rhinodavid/rhinodavid_kicad/README.MD

# @rhinodavid KiCad Parts Library

<!-- This an autogenerated file! DO NOT EDIT. Update README.hbs and run generate script. <-->

> High quality eCAD parts made by me. Shared with you.

KiCad assets for parts I'm
using in my designs. These are parts that I couldn't find eCAD resources for on
the internet, so I made them by hand.

Most of these parts are available on
Digikey. Look for a link to Digikey in the symbol metadata.

## Compatibility

KiCad 6.0 and above

## Adding a part

- Add symbol to library using eSchema
- Add footprint to `rhinodavid.pretty` directory
- Add STEP file to `rhinodavid.pretty` directory
  - Make sure the 3D model is assigned to and properly positioned on the footprint
- Add images to `./docs/readme/img`
- Update `./docs/readme/data.json` with the new part
- Regenerate the README
  - This requires the [Handlebars CLI](https://www.npmjs.com/package/hbs-cli)
  - Run `./docs/readme/generate.sh`

## Parts

### Legend

<div>
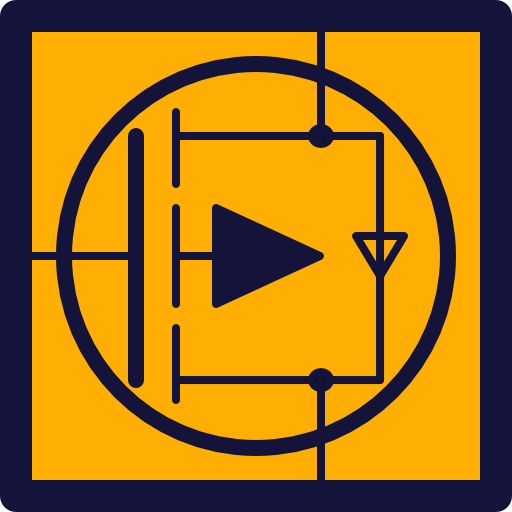
[picture p1: docs/readme/symbol_icon_alternate.png]
Symbol available
        
        <span>Symbol included</span>
</div>
<div>
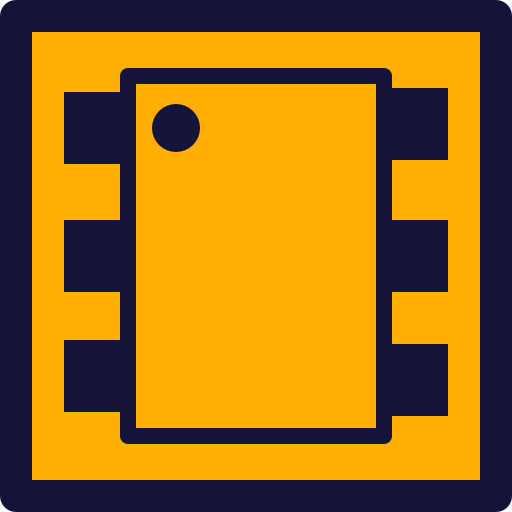
[picture p2: docs/readme/footprint_icon_alternate.png]
Footprint available
        
        <span>Footprint included</span>
</div>
<div>
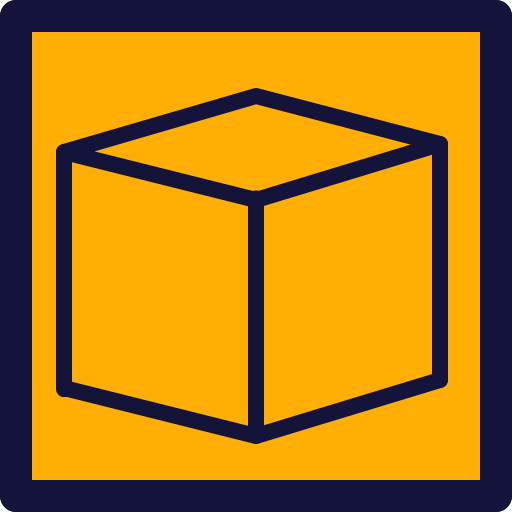
[picture p3: docs/readme/model_icon_alternate.png]
Model available
        
        <span>3D model included</span>
</div>

### OLED_SSD1306_folded

<div display="flex">
        Symbol available
        Footprint available
        Model available
</div>

<p>

192x64 OLED display available on eBay and [buydisplay.com](https://www.buydisplay.com/datasheet-128x64-oled-module-spi-0-96-inch-graphic-displays-white-on-black).<br />The display is mounted face down and then folded backwards.

</p>

<div display="flex">
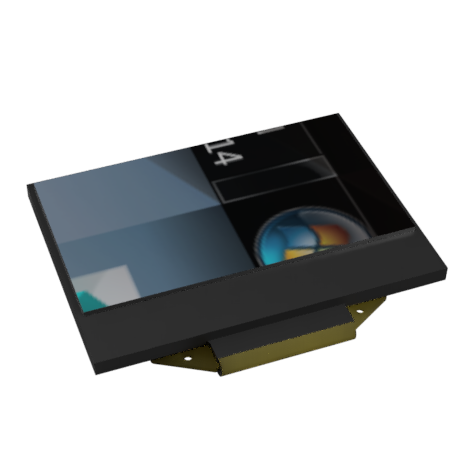
[picture p4: docs/readme/img/OLED-SSD1306-128X64_folded_render.png]
    
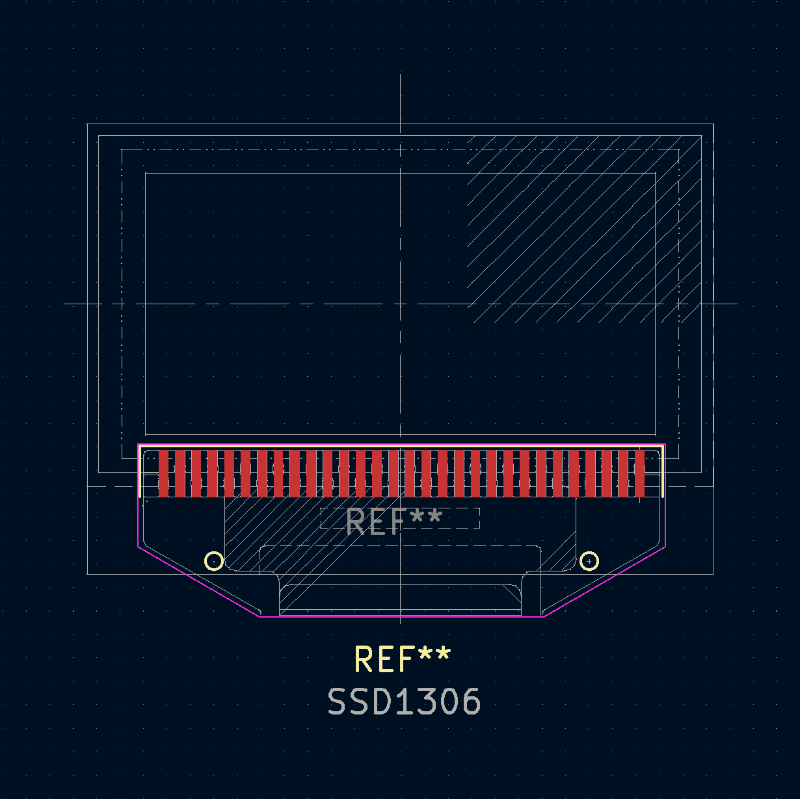
[picture p5: docs/readme/img/OLED-SSD1306-128X64_folded_footprint.png]
    
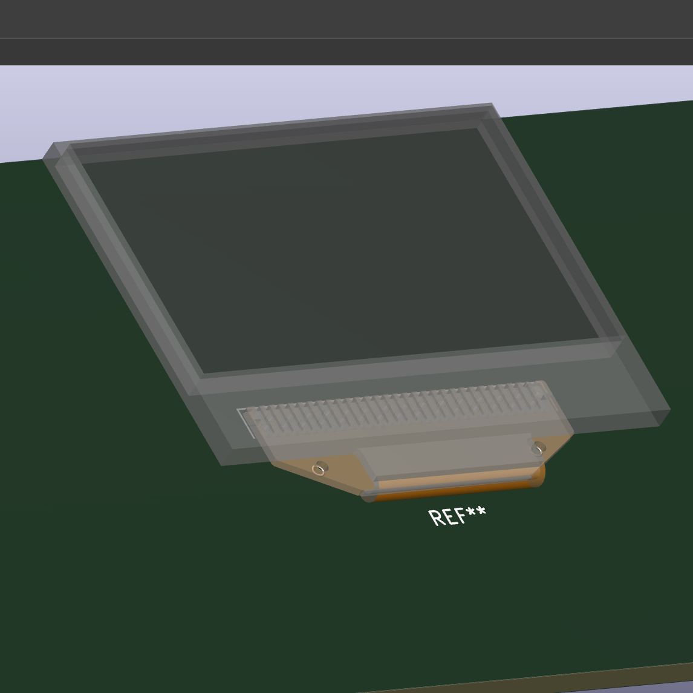
[picture p6: docs/readme/img/OLED-SSD1306-128X64_folded_model.png]
    
</div>

### MMSZ5261BT1G

<div display="flex">
        Symbol available
        Footprint available
        Model available
</div>

<p>

Zener Diode 47 V 500 mW ±5% Surface Mount SOD-123.

</p>

<div display="flex">
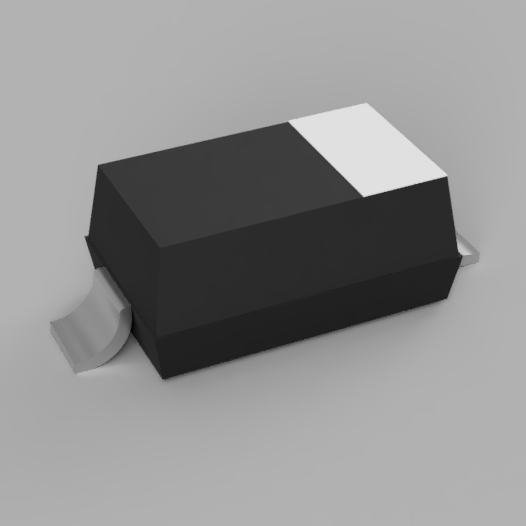
[picture p7: docs/readme/img/MMSZ5261BT1G_render.png]
    
</div>

### Adafruit Neopixel Mini 4957

<div display="flex">
        Symbol available
        Footprint available
        Model available
</div>

<p>

SK6812MINI Neopixel LED in a 3.5mm x 3.5mm package.

</p>

<div display="flex">
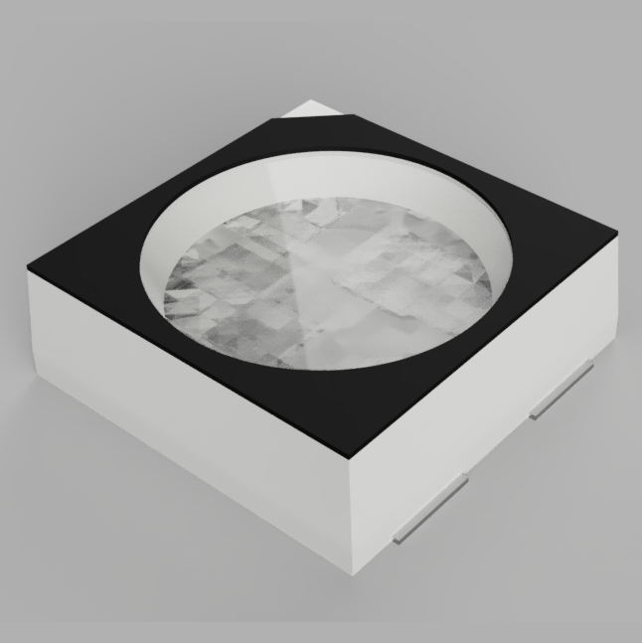
[picture p8: docs/readme/img/SK6812MINI_render.png]
    
</div>

### 1206L150TH

<div display="flex">
        Symbol available
        Footprint available
        Model available
</div>

<p>

Littelfuse, Inc. Polymeric PTC Resettable Fuse 8V 1.5 A in a SMD 1206 package.

</p>

<div display="flex">
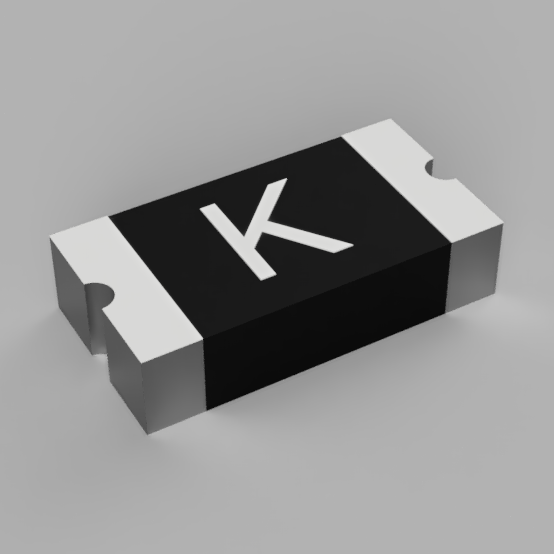
[picture p9: docs/readme/img/1206L150TH_render.png]
    
</div>

### SSM3J331R

<div display="flex">
        Symbol available
        Footprint available
        Model available
</div>

<p>

P-Channel SMD MOSFET, 20 V 4A 1W SOT-23F.

</p>

<div display="flex">
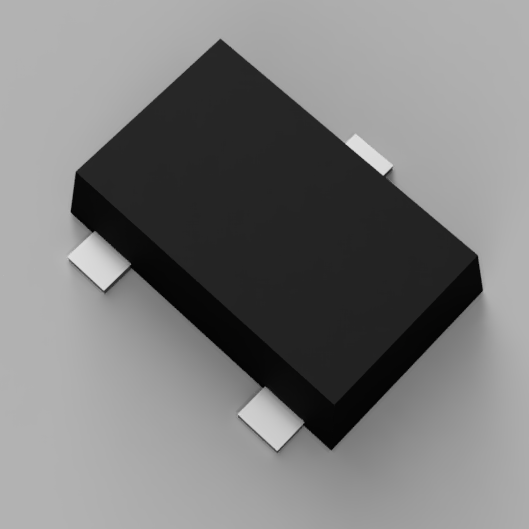
[picture p10: docs/readme/img/SSM3J331R_render.png]
    
</div>

### 74AUP1T00GX

<div display="flex">
        Symbol available
        Footprint available
        Model available
</div>

<p>

1 Channel Schmitt Trigger NAND Gate IC in a 5-X2SON (0.80mm x 0.80mm) package. Great for button debouncing.

</p>

<div display="flex">
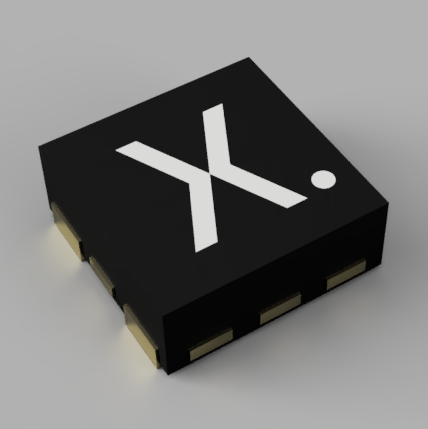
[picture p11: docs/readme/img/74AUP1T00GX_render_1.png]
    
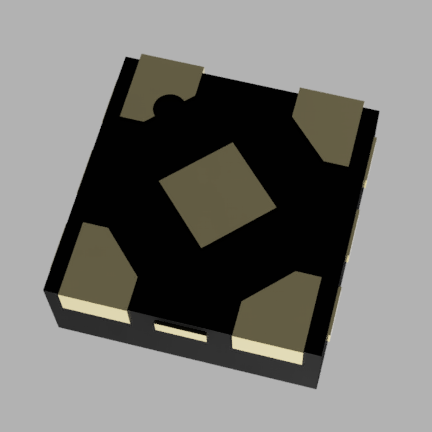
[picture p12: docs/readme/img/74AUP1T00GX_render_2.png]
    
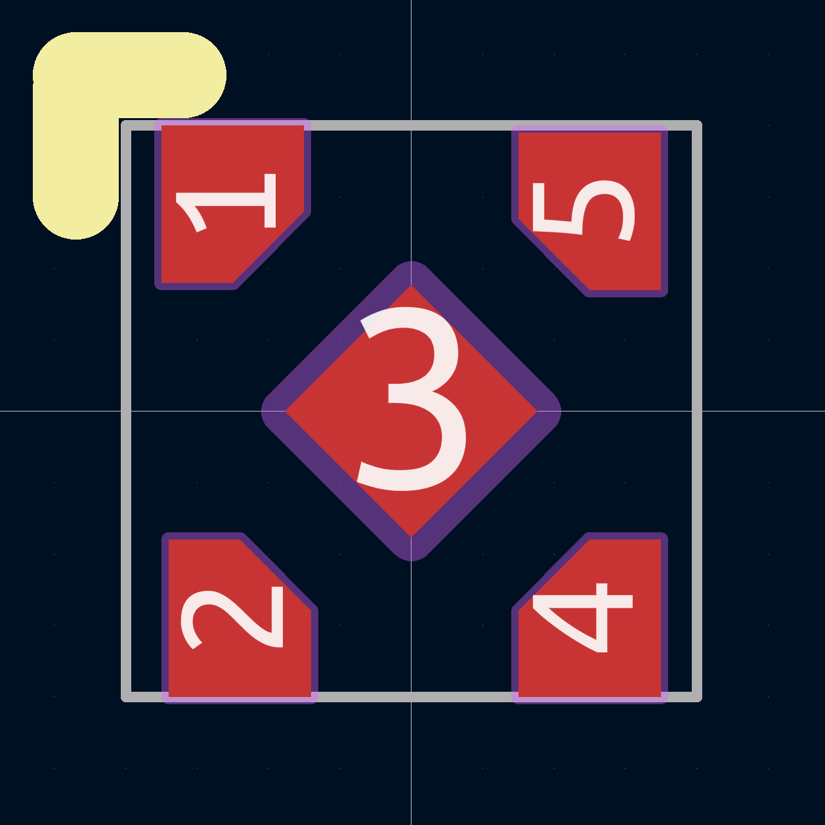
[picture p13: docs/readme/img/74AUP1T00GX_footprint.png]
    
</div>

### TLSM-D-T3-C-020-G

<div display="flex">
        Symbol available
        Footprint available
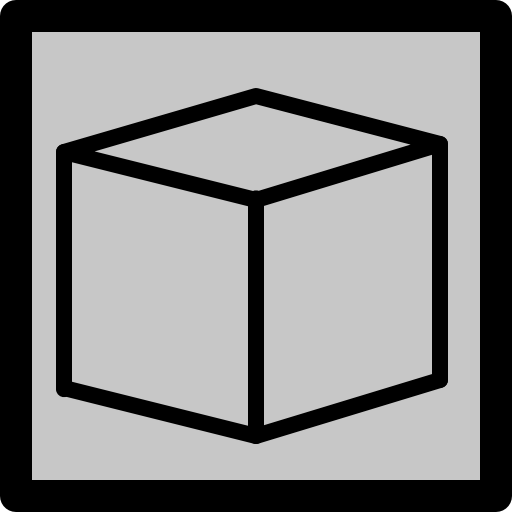
[picture p14: docs/readme/model_icon.png]
Model unavailable
        
</div>

<p>

6mm SPDT SMD tactile switch. Use with 74AUP1T00GX for a debounce.

</p>

<div display="flex">
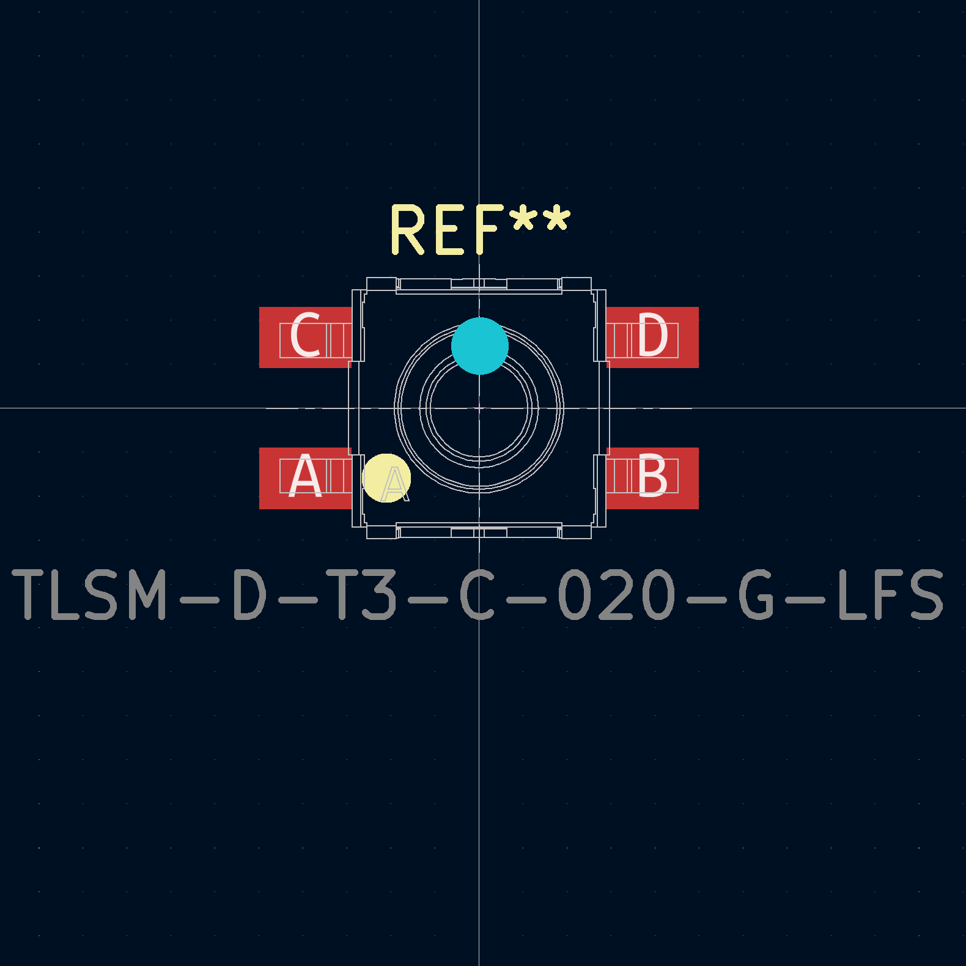
[picture p15: docs/readme/img/TLSM-D-T3-C-020-G-LFS.png]
    
</div>

### TBL003-254-04GR-2OR

<div display="flex">
        Symbol available
        Footprint available
        Model available
</div>

<p>

4 Position Wire to Board Terminal Block Horizontal 0.1" (2.54mm) Through Hole.

</p>

<div display="flex">
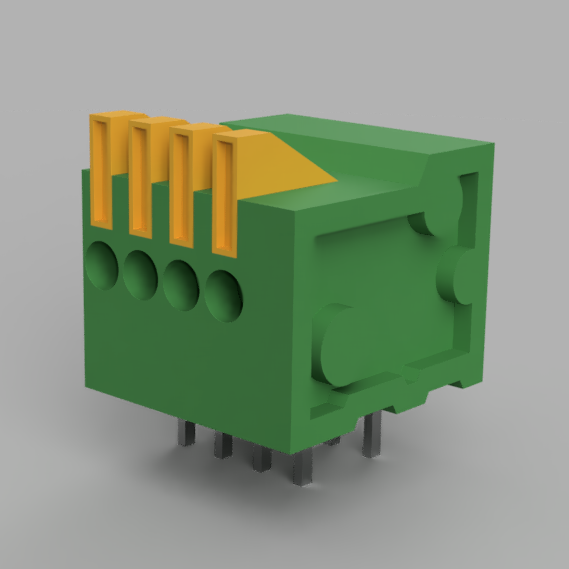
[picture p16: docs/readme/img/TBL003-254-04GR-2OR_render.png]
    
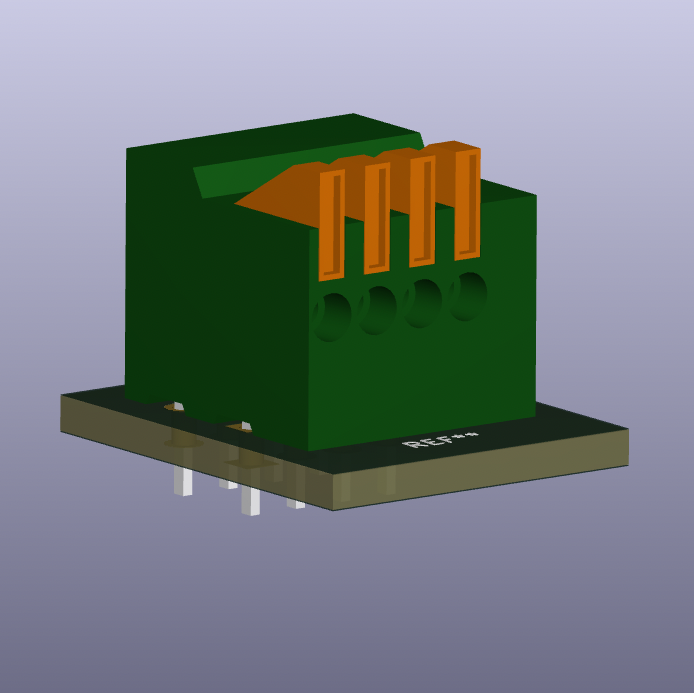
[picture p17: docs/readme/img/TBL003-254-04GR-2OR_model.png]
    
</div>

### BU33UV7NUX

<div display="flex">
        Symbol available
        Footprint available
        Model available
</div>

<p>

Synchronous Boost DC/DC Converter 3.3 V

</p>

### TPS61098x

<div display="flex">
        Symbol available
        Footprint available
        Model available
</div>

<p>

Ultra-Low Quiescent Current Synchronous Boost with Integrated LDO/Load Switch

</p>

<div display="flex">
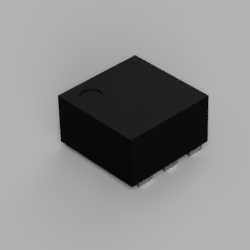
[picture p18: docs/readme/img/TPS61098x_render.png]
    
</div>

### 831068248

<div display="flex">
        Symbol available
        Footprint available
        Model available
</div>

<p>

Wurth Electronic IQXO-540 Standard 2 x 1.6 crystal oscillator in a ceramic package with a seam sealed metal lid, hermetically sealed.

</p>

<div display="flex">
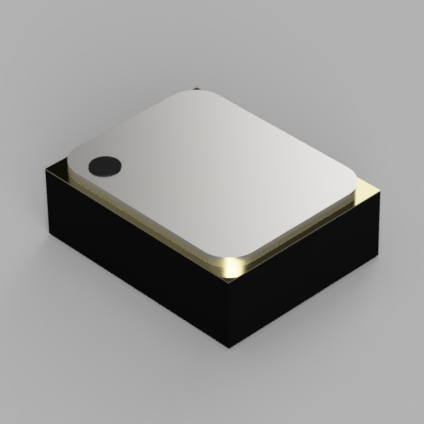
[picture p19: docs/readme/img/831068248_render.png]
    
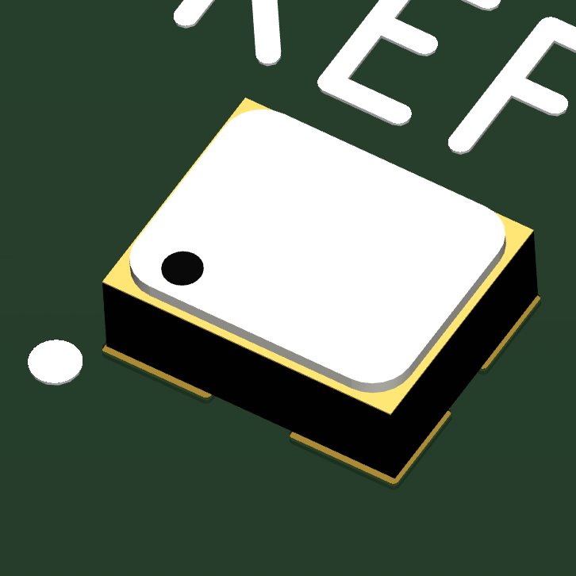
[picture p20: docs/readme/img/831068248_model.png]
    
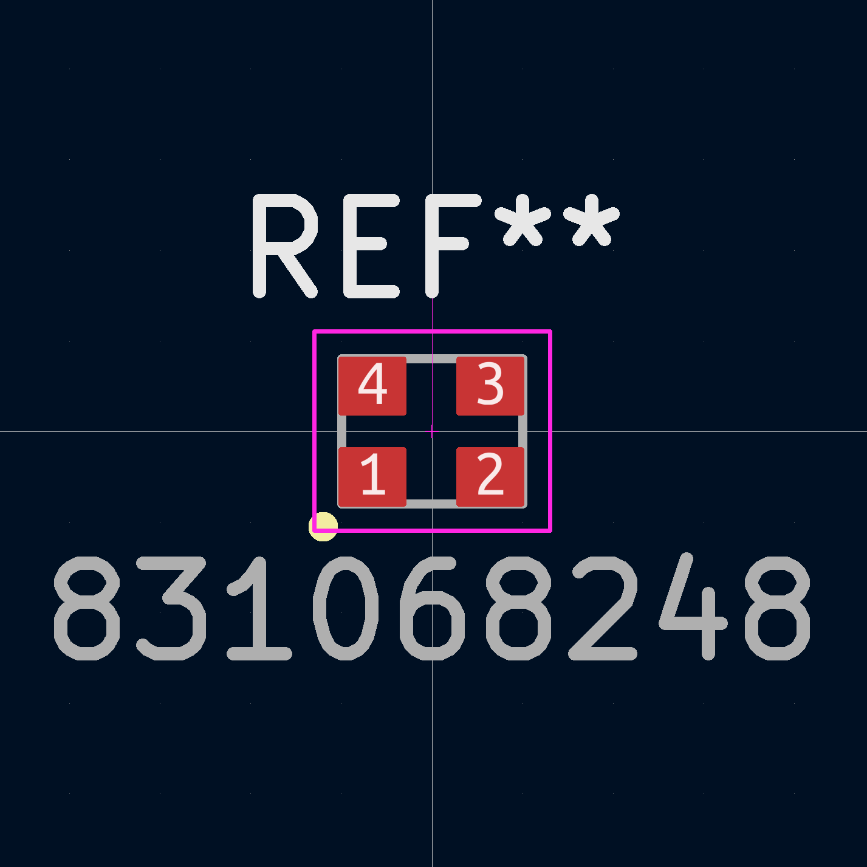
[picture p21: docs/readme/img/831068248_footprint.png]
    
</div>

### AMCA31-2R450G-S1F-T3

<div display="flex">
        Symbol available
        Footprint available
        Model available
</div>

<p>

Surface Mount WLAN / Bluetooth Chip Antenna (2450MHz)

</p>

<div display="flex">
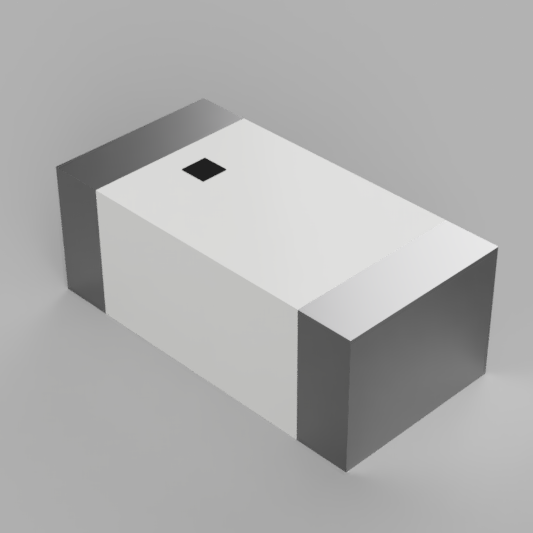
[picture p22: docs/readme/img/AMCA31-2R450G-S1F-T3_render.png]
    
</div>

### SMBJ8.0D-M3/H

<div display="flex">
        Symbol available
        Footprint available
        Model available
</div>

<p>

Vishay General Semiconductor TVS Diode 13.4VC; DO214AA package

</p>

<div display="flex">
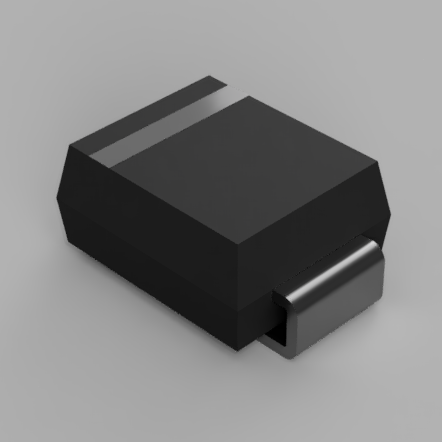
[picture p23: docs/readme/img/SMBJ8.0D-M3H_render.png]
    
</div>

### JTX310

<div display="flex">
        Symbol available
        Footprint available
        Model available
</div>

<p>

Jauch Quartz 32.768 kHz ±20ppm Crystal 7pF 70 kOhms 2-SMD, No Lead

</p>

<div display="flex">
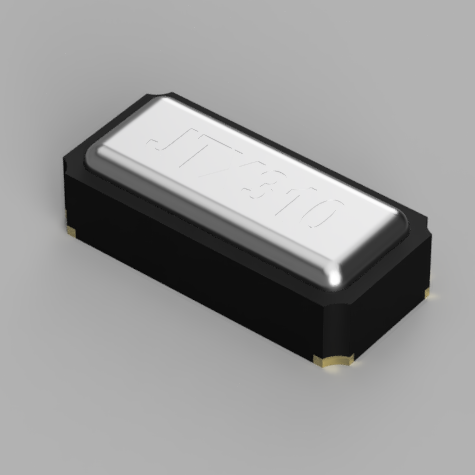
[picture p24: docs/readme/img/JTX310_render.png]
    
</div>

### DMN2005K-7

<div display="flex">
        Symbol available
        Footprint available
        Model available
</div>

<p>

Diodes Inc. N-Channel 20V 300mA (Ta) 350mW (Ta) Surface Mount SOT-23-3 MOSFET

</p>

<div display="flex">
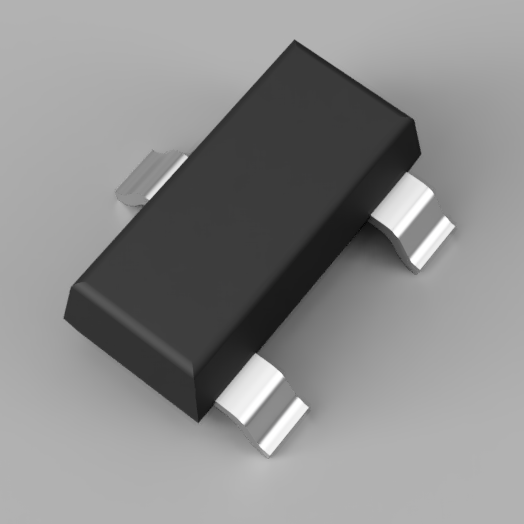
[picture p25: docs/readme/img/DMN2005K-7_render.png]
    
</div>

### LDL1117S33R

<div display="flex">
        Symbol available
        Footprint available
        Model available
</div>

<p>

STMicroelectronics Linear Voltage Regulator IC Positive Fixed 1 Output 1.2A SOT-223

</p>

<div display="flex">
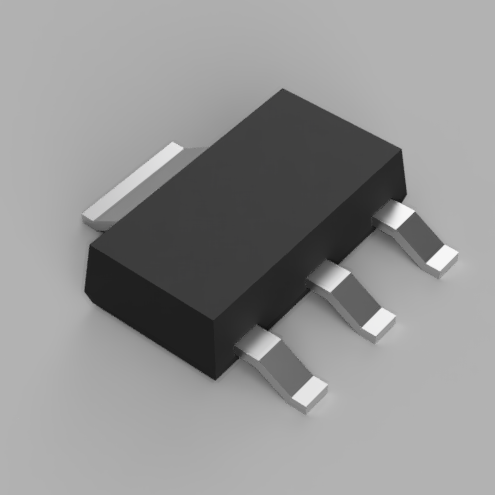
[picture p26: docs/readme/img/LDL1117S33R_render.png]
    
</div>

### PKMCS0909E4000-R1

<div display="flex">
        Symbol available
        Footprint available
        Model available
</div>

<p>

Murata Electronics Buzzer Transducer, Externally Driven Piezo 1.5 V - 4kHz 65dB @ 1.5V, 10cm Surface Mount

</p>

<div display="flex">
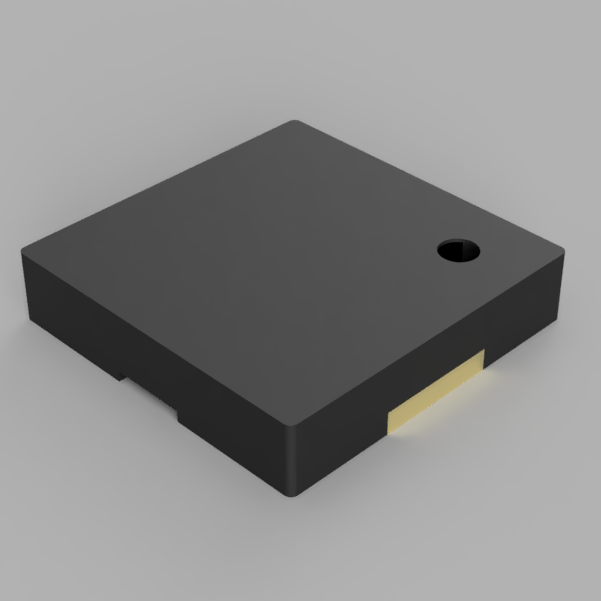
[picture p27: docs/readme/img/PKMCS0909E4000-R1_render.png]
    
</div>

### EC-10

<div display="flex">
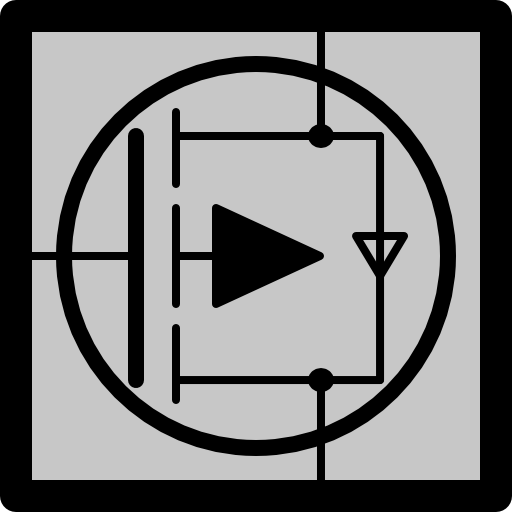
[picture p28: docs/readme/symbol_icon.png]
Symbol unavailable
        
        Footprint available
        Model unavailable
</div>

<p>

Tag Connect EdgeConnect 10-pin Castellated Board-Edge Connector

</p>

<div display="flex">
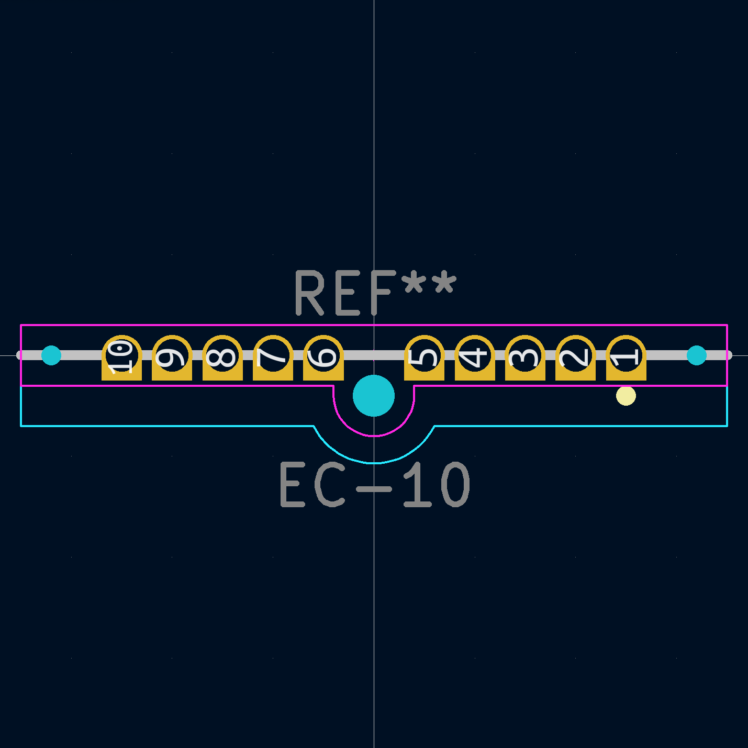
[picture p29: docs/readme/img/EC-10_footprint.png]
    
</div>

### Arm 10 Pin

<div display="flex">
        Symbol available
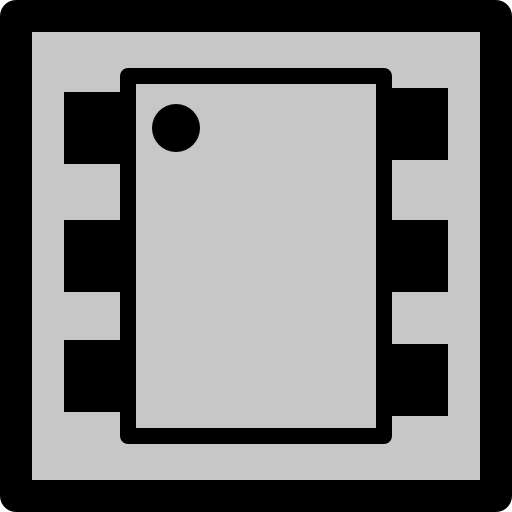
[picture p30: docs/readme/footprint_icon.png]
Footprint unavailable
        
        Model unavailable
</div>

<p>

An ARM 10 pin connector with pin definitions for JTAG and SWD

</p>

<div display="flex">
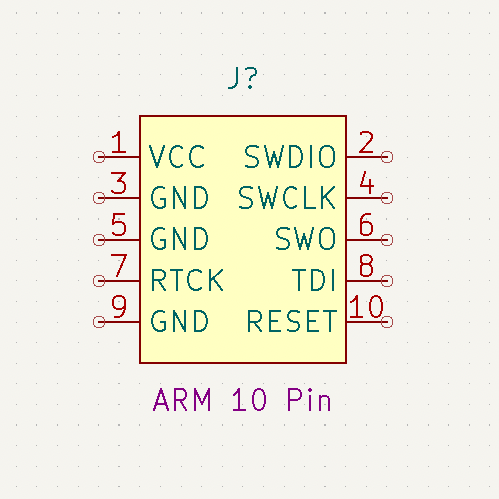
[picture p31: docs/readme/img/ARM_10_Pin_schematic.png]
    
</div>

### STLink V2 Clone Adapter

<div display="flex">
        Symbol available
        Footprint unavailable
        Model unavailable
</div>

<p>

Check your clone to make sure the pinout is the same -- some vary

</p>

<div display="flex">
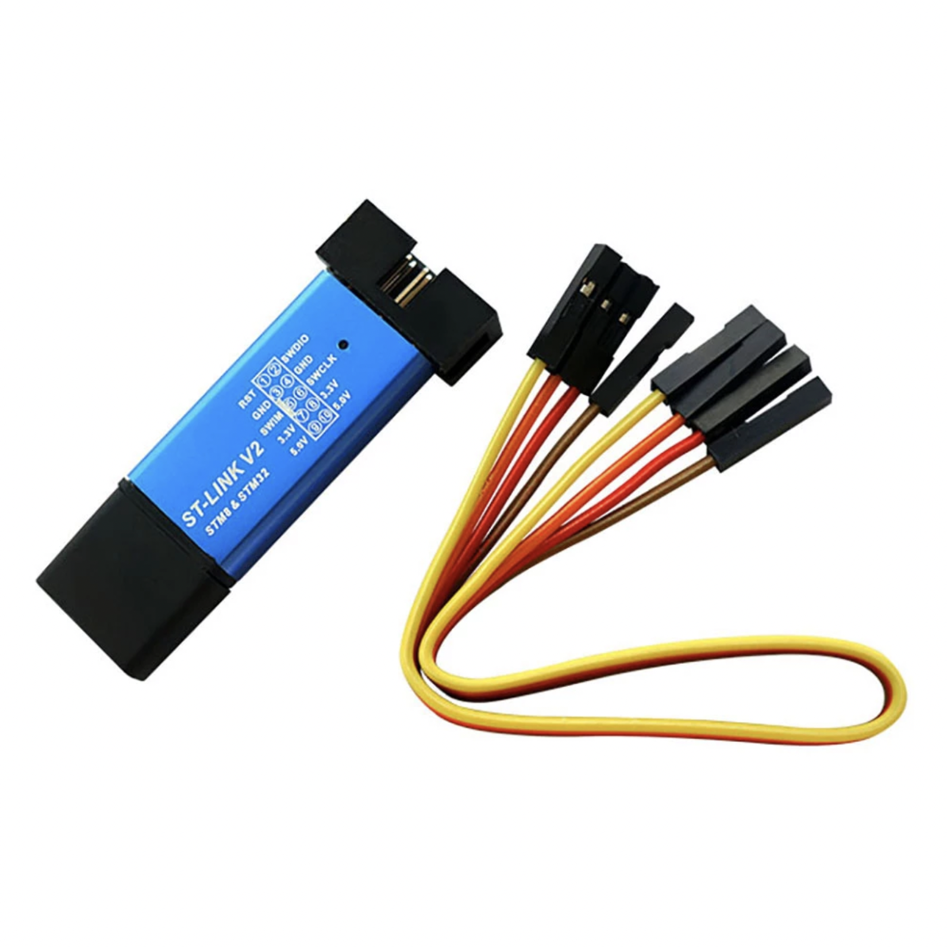
[picture p32: docs/readme/img/STLink_V2.png]
    
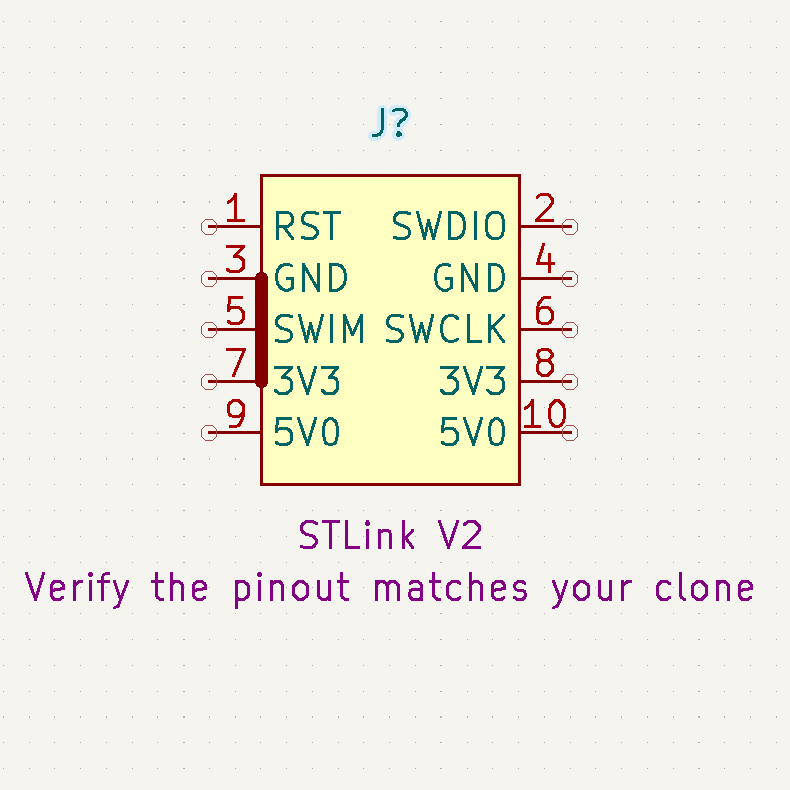
[picture p33: docs/readme/img/STLink_V2_schematic.png]
    
</div>

### ECX-1637

<div display="flex">
        Symbol available
        Footprint available
        Model available
</div>

<p>

4-SMD no lead crystal oscillator

</p>

<div display="flex">
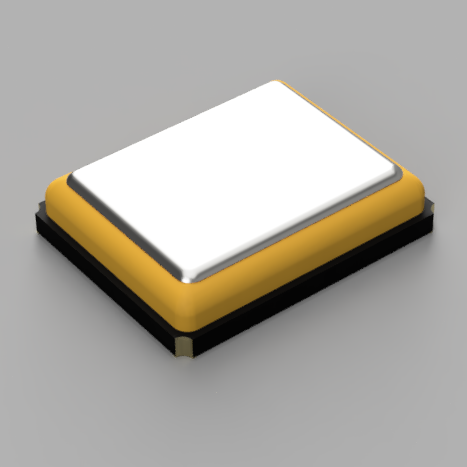
[picture p34: docs/readme/img/ECX-1637_render.png]
    
</div>
