rhinodavid/rhinodavid_kicad/(commit log)

2022-03-12 Create SSD1306 Footprint and symbol
2022-03-13 Add MMSZ52xxxT1G diode
2022-03-13 Add SSM3J331 Mosfet
2022-03-13 Add primary color footprint
2022-03-13 Update neopixel footprint
2022-03-13 Add TLSM switch
2022-03-21 Add SSM3J331R footprint
2022-03-21 Add 74AUP1T00GX footprint
2022-03-27 Add AMCA31-2R450G-S1F-T3 2.4ghz antenna
2022-03-27 Round footprint pads
2022-03-27 Update 1206L150TH footprint and add model
2022-03-27 Add DMN2005K-7 mosfet
2022-03-29 Add EC-10 EdgeConnect footprint
2022-03-29 Change EC-10 footprint type
2022-03-31 Update EC-10 footprint dot to arrow to match connector
2022-04-01 Update footprint pin 1 markers
2022-04-09 Add ARM 10 Pin model
